FaizeenHoque/HyprboardV2/RENDERS/AnotherFrontBackAngleThingz.png

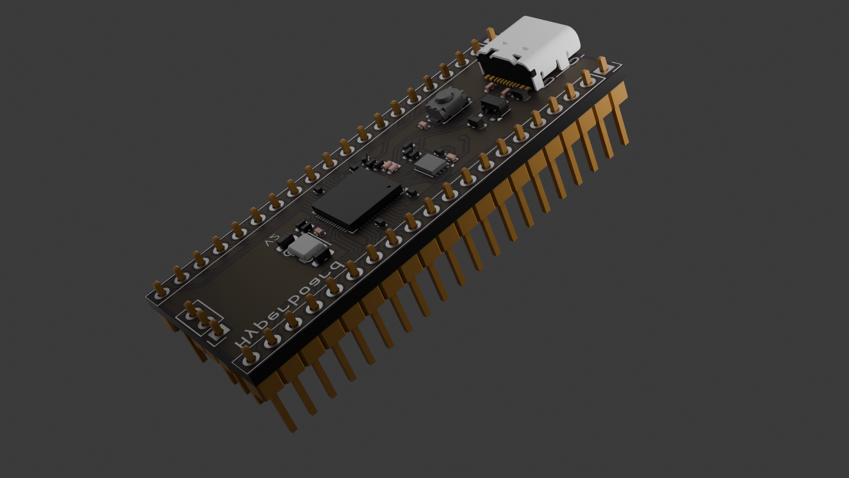
RENDERS/AnotherFrontBackAngleThingz.png
