FaizeenHoque/HyprboardV2/RENDERS/FRONTANGLE.png

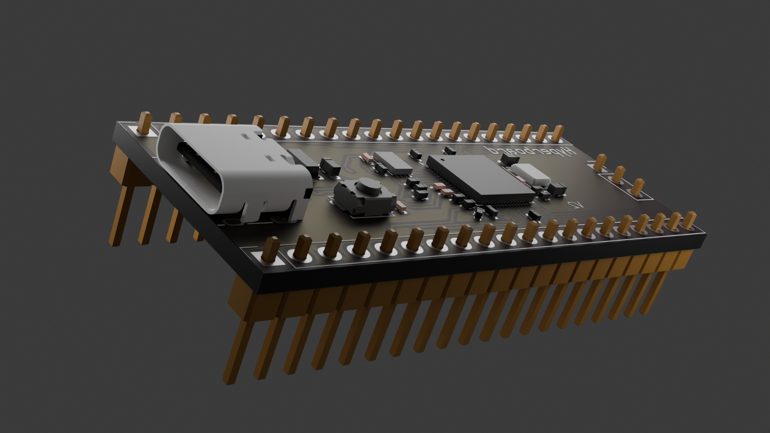
RENDERS/FRONTANGLE.png
