FaizeenHoque/HyprboardV2/production/bom.csv

Designator | Footprint | Quantity | Value | LCSC Part #
C1, C11, C12, C17, C2, C3, C4, C5, C6, C7, C8, C9 | 0402 | 12 | 0.1uF | C1525
C10 | 0402 | 1 | 1uF | C14445
C13, C14 | 0603 | 2 | 10uF | C15525
C15, C16 | 0603 | 2 | 33pF | C1562
J1 | USB_C_Receptacle_HRO_TYPE-C-31-M-12 | 1 | USB_C_Receptacle_USB2.0_14P | C165948
J2, J3 | PinHeader_1x20_P2.54mm_Vertical | 2 | Conn_01x20 | C50981
J4 | PinHeader_1x03_P2.54mm_Vertical | 1 | Conn_01x03 | C49257
R1, R2 | 0402 | 2 | 5.1K | C25905
R3, R4 | 0402 | 2 | 27 | C11896
R5, R6 | 0402 | 2 | 1K | C11702
R7 | 0402 | 1 | 10K | C25531
SW1 | SW_Push_SPST_NO_Alps_SKRK | 1 | SW_Push | C202388
U1 | QFN-56-1EP_7x7mm_P0.4mm_EP3.2x3.2mm | 1 | RP2040 | C2040
U2 | SOT-23 | 1 | MCP1700x-330xxTT | C39051
U4 | Winbond_USON-8-1EP_3x2mm_P0.5mm_EP0.2x1.6mm | 1 | W25Q16JVZPIQ TR | C2843335
Y1 | Crystal_SMD_3225-4Pin_3.2x2.5mm | 1 | 12 MHz | C481407
