FaizeenHoque/HyprboardV2/(list of files, cad)

Other CAD files:
RENDERS/renders.blend
