FaizeenHoque/HyprboardV2/(commit log)

2026-03-06 finished up with the decoupling capacitors, finished up with the USB
2026-03-06 Crystal Oscilator, Flash Memory done! Started working on the breakout for GPIO pins
    [HyprboardV2.kicad_sch]
2026-03-06 Finished up the schematic
    [HyprboardV2.kicad_sch]
2026-03-06 Changed the stuff Flash and USB components, 1/3rd positioned the components
    [HyprboardV2.kicad_pcb, HyprboardV2.kicad_sch]
2026-03-06 Position 2/3rd of the components
    [HyprboardV2.kicad_pcb]
2026-03-07 Almost dont placements, ill start routing next and do the rest simulatneously
    [HyprboardV2.kicad_pcb]
2026-03-07 DONE WITH THE ROUTINGGGgit add .! checkout stasis's journal for info
    [HyprboardV2.kicad_pcb, HyprboardV2.kicad_sch, freerouting.dsn, temp-freerouting.dsn]
2026-03-07 Added some renders, and added some text to the boarddddgit add .!
    [HyprboardV2.kicad_pcb, HyprboardV2.kicad_sch, freerouting.dsn, renders.blend, temp-freerouting.dsn]
2026-03-07 Create README.md for HyprboardV2
    Added initial README for HyprboardV2 with features, schematic, PCB, renders, BOM, getting started guide, license, and acknowledgements.
2026-03-07 Remove BOM file reference from README
    Removed reference to the full BOM file location.
2026-03-08 production files
    [bom.csv, designators.csv, positions.csv]
2026-03-15 Revise README with features and BOM details
    Updated features, BOM, and added passive components section in README.
2026-03-15 Revise section headers and BOM pricing
    Updated section headers and BOM cost in README.md.
2026-03-20 Modify BOM with part numbers and values
    Updated component values and added LCSC part numbers.
    [bom.csv]
